csace22003/Airdahl/README.md

# Airdahl
Big Bad Capstone Flight Computer
