csace22003/Airdahl/GPT Response to Airdahl Schematic.docx

Yes. I parsed the uploaded KiCad schematic and traced the nets. I see several items worth fixing or at least verifying before layout/fabrication.

The most important one is the USB-to-UART connection around U2 (MCP2200) and U1 (STM32F446). In the schematic, U2 TX is on the net UART_TX, and that same net reaches U1 PA11. U2 RX is on UART_RX, but I do not see that net reaching an STM32 UART RX pin. In other words, the bridge appears to have TX connected to a pin that is not an obvious USART TX/RX counterpart, while RX is not connected to the MCU. The schematic itself labels the intended UART assignment as RX: PC10 / TX: PC11, so this looks inconsistent with the actual net connectivity.

I would therefore check the intended UART channel first. If you intend to use USART3 on PC10/PC11, then typically the bridge should be cross-connected:

MCP2200 TX→STM32 RX MCP2200 RX←STM32 TX

and the selected STM32 pins need to support that USART alternate function. At present, PC10 and PC11 also appear to be involved in the SDIO-related routing through the 22- Ω resistors, so there may also be a pin-multiplexing conflict depending on your firmware/interface plan.

A second issue is the SPI chip-select path. The carrier-board connector has a net named SPI_CS, but the MCU-side SPI chip-select appears to be named CS_RFM on a different net. I do not see those two nets joined. If SPI_CS is intended to be driven by the STM32, that connection looks missing. The clock, MISO, and MOSI paths are present, so the isolated CS net stands out.

A third thing I would verify is the MCP2200 exposed pad. U2 is using the QFN-20-1EP footprint, and the schematic symbol includes pin 21 EP. In the parsed schematic, that pin does not appear electrically connected to GND. For an exposed-pad QFN device, this is normally something you should explicitly verify against the Microchip datasheet and footprint implementation. I would not leave the thermal/exposed pad floating unless the datasheet specifically permits it.

There are also several lower-level items I would review:

- The USB-C CC1 and CC2 pins each have 5.1 kΩ to ground, which is correct for a USB device/UFP configuration.
- USB D+ and D− are correctly paired between the USB-C receptacle and MCP2200.
- The USB shield is tied directly to digital GND. That can work, but for EMC/ESD-sensitive hardware you may want to reconsider whether you want direct grounding, RC/chassis coupling, or a dedicated shield strategy.
- I do not see obvious USB ESD protection on D+/D− or VBUS. That is not logically required for operation, but for a flight-computer board it is worth adding.
- U7, the NCP1117-3.3, has 10-µF input and output capacitors, which is sensible for that regulator family.
- The STM32 has the expected VCAP capacitor and multiple VDD decoupling capacitors; the general architecture looks reasonable.
- VDDA is fed from 3.3 V through ferrite bead L1 and has local capacitors, which is good practice.
- The RTC backup battery is connected to VBAT and ground in a conventional manner.
- BOOT0 has a pulldown and switch network, and NRST has the expected reset-switch/capacitor network.

One thing that caught my attention structurally is that J2 and J3, the two 34-pin board-to-board connectors, do not appear to carry any GND pins in this schematic. They carry many digital/analog signals and +3V3_REG, but I do not see a ground connection through either connector. If those connectors mate this mainboard to carrier boards, this would be a serious concern unless ground is provided mechanically or through some other connector not shown. High-speed interfaces such as SPI/SDIO particularly need a defined return path. I would verify this before anything else on the connector design.

I would rank the findings this way:

1. High priority: UART connection around MCP2200 ↔ STM32 looks wrong/incomplete.
2. High priority: Verify that J2/J3 really have no GND conductors.
3. Medium-high priority: SPI_CS and CS_RFM appear to be separate nets.
4. Medium priority: MCP2200 exposed pad appears unconnected.
5. Design robustness: add/review USB ESD protection and shield grounding.
6. Pin-mux review: make sure UART, SDIO, SPI, and payload functions do not claim the same STM32 pins.

The rest of the power architecture, STM32 decoupling, USB-C CC configuration, oscillator networks, and basic reset/boot circuitry look broadly sensible from the connectivity I traced.

If you want, I can do a more systematic pin-by-pin design review next, organized as:

power → STM32 pins → USB/MCP2200 → clocks → SWD → J2/J3 carrier interface → SPI/I²C/SDIO → LEDs/buttons, and produce a table of every suspect net and recommended correction.

I went through the uploaded AirDahl Flight Computer Mainboard schematic at the net level and cross-checked the more important device requirements against the relevant datasheets. There are several real issues I would address before PCB fabrication.

One correction to my previous response first: the MCP2200 exposed pad is not an error. Microchip explicitly allows the EP to be either left electrically unconnected or tied to VSS. (Microchip (https://ww1.microchip.com/downloads/en/DeviceDoc/22228A.pdf?utm_source=chatgpt.com))

### Systematic review

Priority | Circuit / net | What I found | Recommendation
High | MCP2200 ↔ STM32 UART | MCP2200 TX (U2 pin 7) goes to UART_TX, which is connected to STM32 PA11. MCP2200 RX (pin 9) goes to UART_RX, but that net only reaches J3 and does not reach the MCU. Therefore the USB-UART bridge is not wired as a functional full-duplex MCU UART. | Reroute TX/RX to a valid STM32 UART pair and cross-connect: MCP2200 TX → MCU RX, MCP2200 RX ← MCU TX.
High | UART annotation / SDIO conflict | The schematic note says RX: PC10, TX: PC11. That is reversed: on STM32F446, PC10 = USART3_TX and PC11 = USART3_RX. Worse, PC10 and PC11 are already being used as SDIO_D2 and SDIO_D3. (STMicroelectronics (https://www.st.com/resource/en/datasheet/DM00141306.pdf?utm_source=chatgpt.com)) | Decide whether you need 4-bit SDIO and the USB UART simultaneously. If yes, choose a different UART pair, e.g. USART1 PA9/PA10 or USART3 PB10/PB11 if those pins are available.
High | J2/J3 ground return | I find no GND pins on either 34-pin board-to-board connector. Both carry signals and +3V3_REG, but no electrical ground net. | If these are the only connections to the carrier boards, add several GND pins. Ideally intersperse ground near SPI/UART and power pins. If a separate ground connection exists elsewhere, document it clearly.
High | Main +3.3-V rail after Schottky ORing | USB_3V3, SWD_3V3, and +3V3_REG are ORed through RB496EA Schottkys into +3V3. So the MCU and MCP2200 do not necessarily see 3.3 V; they see 3.3-V_F . RB496EA specifies V_F up to 0.4 V at 1 A. MCP2200 requires VDD ≥3.0 V. (Rohm (https://www.rohm.com/products/diodes/schottky-barrier-diodes/low-vf/rb496ea-product)) | Calculate the rail at worst-case current and temperature. A 3.3-V source followed by a diode is marginal for a nominal 3.3-V system. An ideal-diode/power-mux arrangement would be preferable.
High/conditional | +3V3_REG from J2 and J3 | J2 pin 7 and J3 pin 8 appear directly tied to the same pre-OR +3V3_REG net. | If both carrier boards can independently source 3.3 V, their regulators could be directly paralleled/back-fed. Give each source its own isolation/ORing unless only one can ever be installed/powered.
Medium-high | PB2 / BOOT1 | PB2 is labeled/noted as BOOT1, but appears otherwise floating. Your BOOT0 switch can force BOOT0 high. | If you want reliable entry into the STM32 system-memory bootloader, give PB2/BOOT1 a defined state—typically a pulldown. Otherwise BOOT0=1 can give an indeterminate boot selection.
Medium-high | DEBUG_LED | D5/R51 are connected to a net named DEBUG_LED, but I do not find that net connected to the STM32 or any other driver. | Connect it to an available MCU GPIO or remove it. As drawn, it cannot be software-controlled.
Medium-high | J3 SPI_CS | J3 carries SCLK, MISO, and MOSI, which correctly join the MCU SPI bus, but J3's SPI_CS is not connected to a GPIO. CS_RFM is a different chip-select used by the sensor sheet. | If J3's carrier contains an SPI slave, connect SPI_CS to a separate MCU GPIO. Do not simply merge it with CS_RFM unless the two devices are intentionally selected together.
Medium | MCP2200 VUSB bypass | U2 VUSB is tied to +3V3, which is appropriate at 3.3-V operation, but I do not see a dedicated local VUSB bypass capacitor. Microchip explicitly requires/recommends local high-quality ceramic bypassing; its characterization uses 330 nF. (Microchip (https://ww1.microchip.com/downloads/en/DeviceDoc/22228A.pdf)) | Put roughly 330 nF ceramic directly at VUSB-to-GND, with short traces.
Medium | USB VBUS capacitance | C1 is 10 µF directly on USB VBUS. Microchip notes that total effective capacitance across VBUS must not exceed 10 µF for bus-powered operation unless inrush limiting is provided. (Microchip (https://ww1.microchip.com/downloads/en/DeviceDoc/22228A.pdf?utm_source=chatgpt.com)) | 10 µF nominal leaves little design margin. Verify effective capacitance/tolerance and USB-C inrush behavior.
Medium | NCP1117 output capacitor | C2 is 10 µF, which satisfies the capacitance requirement, but the NCP1117 also specifies an ESR stability range, typically 33 mΩ–2.2 Ω. A modern low-ESR 10-µF ceramic can fall below that. (onsemi (https://www.onsemi.com/download/data-sheet/pdf/ncp1117-d.pdf?utm_source=chatgpt.com)) | Check the exact capacitor ESR over frequency/temp/DC bias, or select an LDO explicitly stable with ceramic output capacitors.
Medium | NCP1117 thermal dissipation | USB power goes 5 V → NCP1117 3.3 V → Schottky → board. At significant current the regulator must dissipate approximately (5-3.3)I , before considering diode loss. | Check worst-case board load and SOT-223 thermal design. At hundreds of mA this becomes nontrivial.
Medium | SWD connector | J1 has SWD_3V3, SWDIO, SWCLK, and GND, but no NRST. Also SWD_3V3 is arranged as a source into the board through D1. | Confirm your debugger actually supplies target power. Many SWD probes expect VTref to be supplied by the target. Adding NRST also improves recovery/connect-under-reset capability.
Medium | USB ESD | I don't see low-capacitance TVS/ESD protection on USB D+/D− or VBUS. | Add USB-rated ESD protection close to J4 if this connector will be routinely handled.
Medium/conditional | Primary Sensors sheet pins | At the top level, BMP_INT, BNO_INT, BNO_RST, D0_RFM, and RST_RFM appear unconnected. | Check whether they are intentionally unused and whether reset/input states are defined inside sensors.kicad_sch. I cannot verify the child circuitry because that file was not included.
Low/medium | ADC inputs PC0/PC1 | PITOT_SGL and PAYLOAD_A each have 100-nF shunt capacitance but no explicit series resistance. | Verify sensor output impedance and STM32 ADC acquisition requirements. If these are intended as low-pass filters, an explicit series R gives you a predictable pole and isolates the ADC/sensor from the capacitor.
Low | RB496EA lifecycle | ROHM lists RB496EA as Not Recommended for New Designs. (Rohm (https://www.rohm.com/products/diodes/schottky-barrier-diodes/low-vf/rb496ea-product)) | For a new board, consider a current-production replacement or an ideal-diode/power-mux solution.
Low / ERC hygiene | Power flags | I did not see PWR_FLAG-style power-source declarations. Because the board rail is fed through passive diode pins, KiCad ERC may not recognize +3V3 as actively driven. | Add appropriate power flags after validating the actual power architecture. This is primarily an ERC bookkeeping issue.

### Interfaces that otherwise look correct

The SPI1 mapping is coherent: PA5 → SCLK, PA6 → MISO, PA7 → MOSI, and PA4 → CS_RFM; the 22-Ω series resistors on several driven lines are reasonable. I²C1 on PB8/PB9 has 4.7-kΩ pullups. The SDIO 4-bit mapping is also internally consistent: PC8=D0, PC9=D1, PC10=D2, PC11=D3, PC12=CLK, and PD2=CMD, which reinforces why PC10/PC11 cannot simultaneously serve as your intended USART3 pair. (STMicroelectronics (https://www.st.com/resource/en/datasheet/DM00141306.pdf?utm_source=chatgpt.com))

The STM32 power implementation is generally good: all VDD/VSS pins appear connected, VDDA is filtered through L1 with local 100-nF/1-µF decoupling, and VCAP1 uses 4.7 µF. ST specifically calls for 4.7 µF with ESR ≤1 Ω for the single-VCAP configuration of this device. (STMicroelectronics (https://www.st.com/resource/en/datasheet/stm32f446rc.pdf?utm_source=chatgpt.com)) The VBAT arrangement, HSE/LSE topology, NRST network, and BOOT0 pulldown/switch also look sensible.

The USB-C device configuration also has the expected 5.1-kΩ Rd resistors on CC1 and CC2. D+/D− are connected correctly to the MCP2200, and the MCP2200 already contains the USB impedance-matching/termination components, so you do not need external series termination resistors solely for that purpose. (Microchip (https://ww1.microchip.com/downloads/en/DeviceDoc/22228A.pdf))

### What I would change before ordering the PCB

The four items I would treat as must-resolve are:

1. Fix the MCP2200 UART routing and the erroneous PC10/PC11 annotation.
2. Confirm/add ground connections on J2 and J3.
3. Reconsider the 3.3-V-through-Schottky power architecture, especially because MCP2200 has a 3.0-V minimum.
4. Determine whether J2 and J3 can both source +3V3_REG; if so, isolate the two sources.

After that, I would fix DEBUG_LED, SPI_CS, PB2/BOOT1, and add the MCP2200 VUSB bypass capacitor.

One important limitation remains: the main schematic references sensors.kicad_sch, but that child sheet was not included in the upload. So I have verified the mainboard-to-sensor-sheet interfaces but not the actual BNO/BMP/RFM/SD-card circuitry, its power decoupling, pullups, interrupt/reset handling, or SD-card implementation. If you upload sensors.kicad_sch, I can continue the same review through that sheet and give you a final “safe to fabricate / remaining blockers” checklist.
