csace22003/Airdahl/ACE Carrier/local-libraries/ADXL345/ADXL345.step

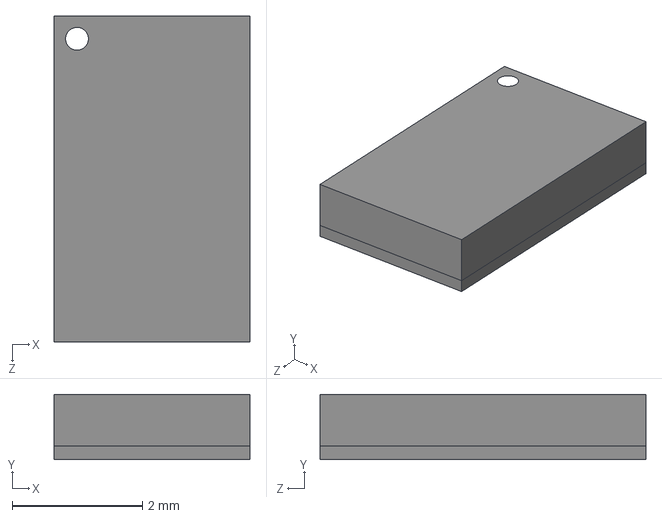
[picture p15: CAD file, 2026-04-10]
ACE Carrier/local-libraries/ADXL345/ADXL345.step
3.00 x 1.00 x 5.00 mm
