csace22003/Airdahl/Airdahl 1.0/local-libraries/ABM3B_8_000MHZ_12_D1X_T/ABM3B-8.000MHZ-12-D1X-T.step

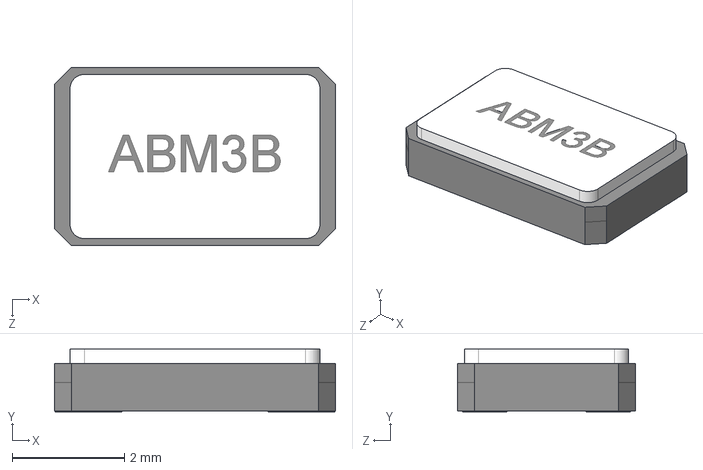
[picture p16: CAD file, 2026-03-30]
Airdahl 1.0/local-libraries/ABM3B_8_000MHZ_12_D1X_T/ABM3B-8.000MHZ-12-D1X-T.step
5.00 x 1.11 x 3.18 mm
