csace22003/Airdahl/Airdahl 1.0/local-libraries/ABS25_32_768KHZ_6_T/ABS25-32.768KHZ-6-T.step

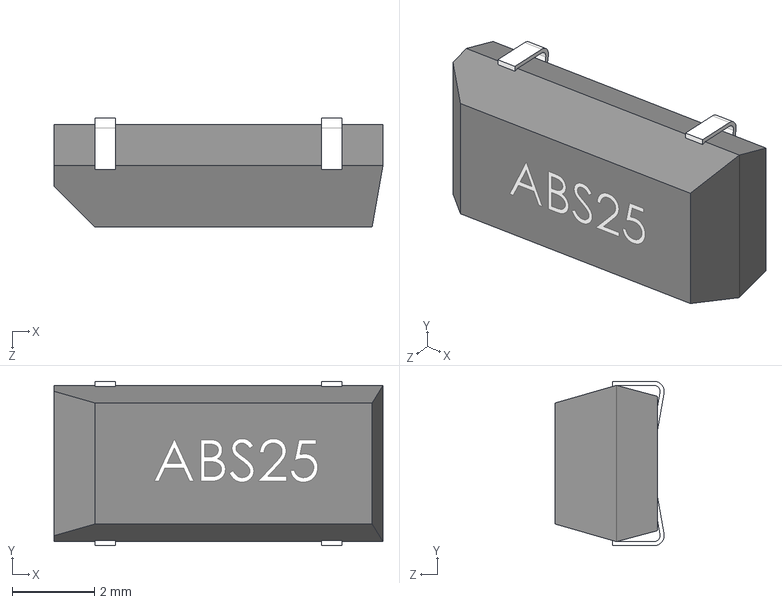
[picture p17: CAD file, 2026-03-27]
Airdahl 1.0/local-libraries/ABS25_32_768KHZ_6_T/ABS25-32.768KHZ-6-T.step
8.00 x 4.00 x 2.66 mm
