csace22003/Airdahl/Airdahl 1.0/local-libraries/BMP581/BMP581.step

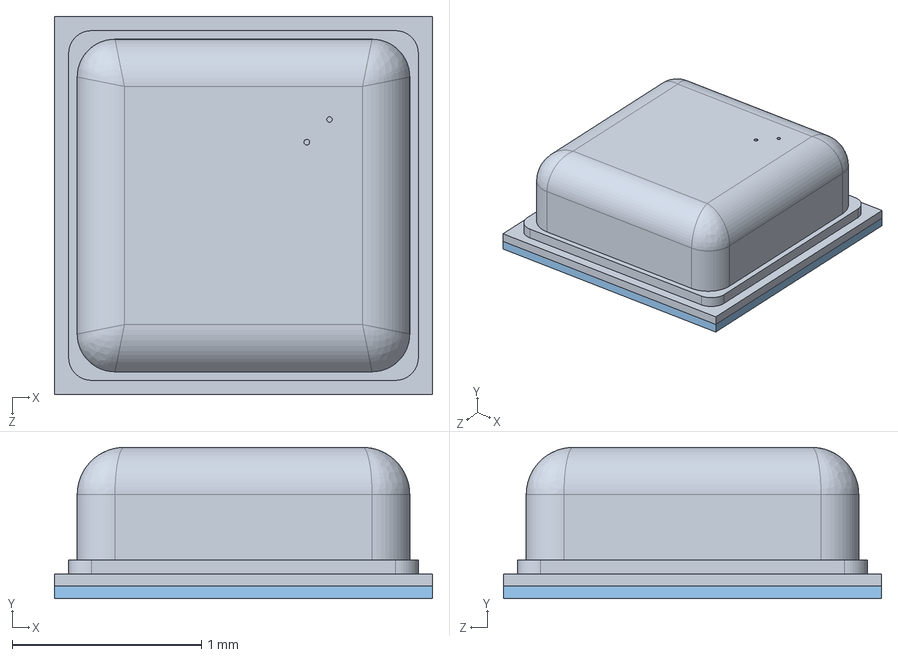
[picture p18: CAD file, 2026-04-10]
Airdahl 1.0/local-libraries/BMP581/BMP581.step
2.00 x 0.801 x 2.00 mm
