csace22003/Airdahl/Airdahl 1.0/local-libraries/BNO085/BNO085.step

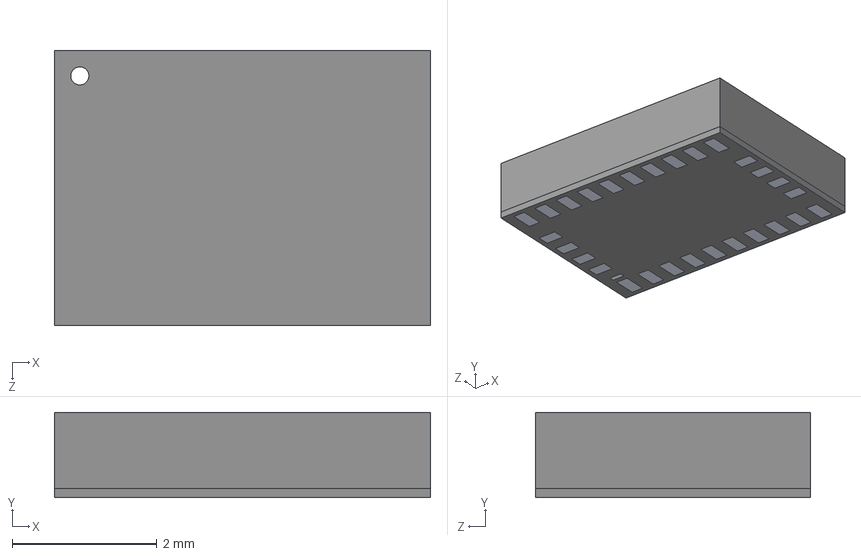
[picture p19: CAD file, 2026-04-10]
Airdahl 1.0/local-libraries/BNO085/BNO085.step
5.20 x 1.18 x 3.80 mm
