csace22003/Airdahl/Airdahl 1.0/local-libraries/CONUFL001-SMD-T/CONUFL001-SMD-T.step

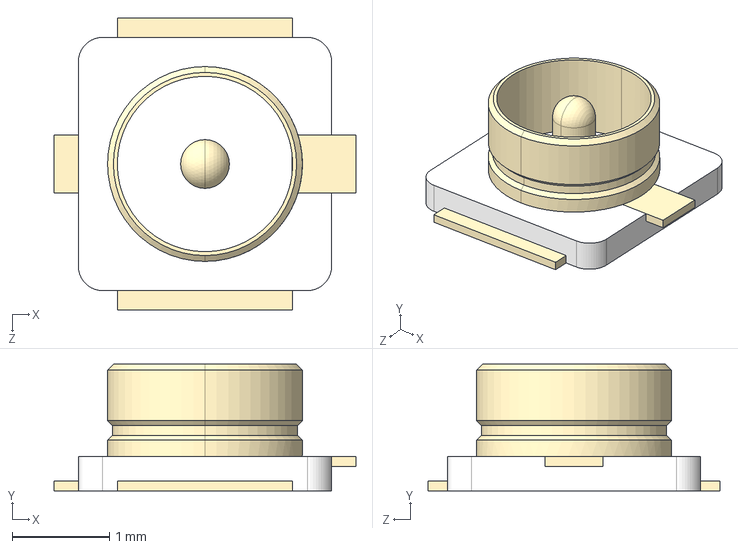
[picture p20: CAD file, 2026-04-17]
Airdahl 1.0/local-libraries/CONUFL001-SMD-T/CONUFL001-SMD-T.step
3.10 x 1.30 x 3.00 mm
