csace22003/Airdahl/Airdahl 1.0/local-libraries/DF40C-34DS-0.4V_58_/DF40C-34DS-0.4V_58_.step

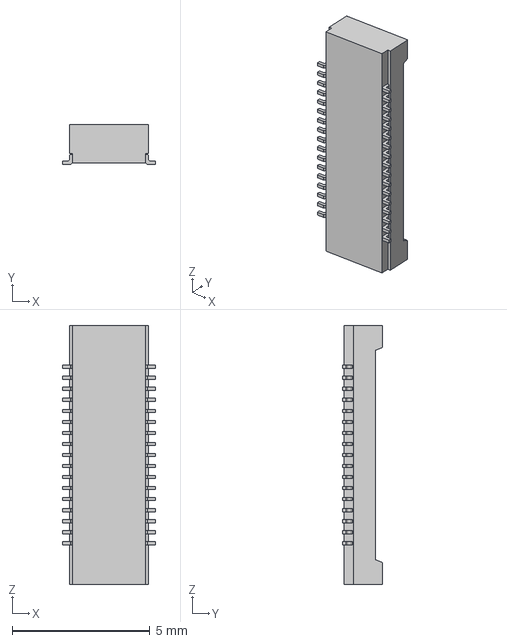
[picture p21: CAD file, 2026-08-17]
Airdahl 1.0/local-libraries/DF40C-34DS-0.4V_58_/DF40C-34DS-0.4V_58_.step
3.38 x 1.45 x 9.40 mm
