csace22003/Airdahl/Airdahl 1.0/local-libraries/LM66200DRLR/DRL0008A.stp

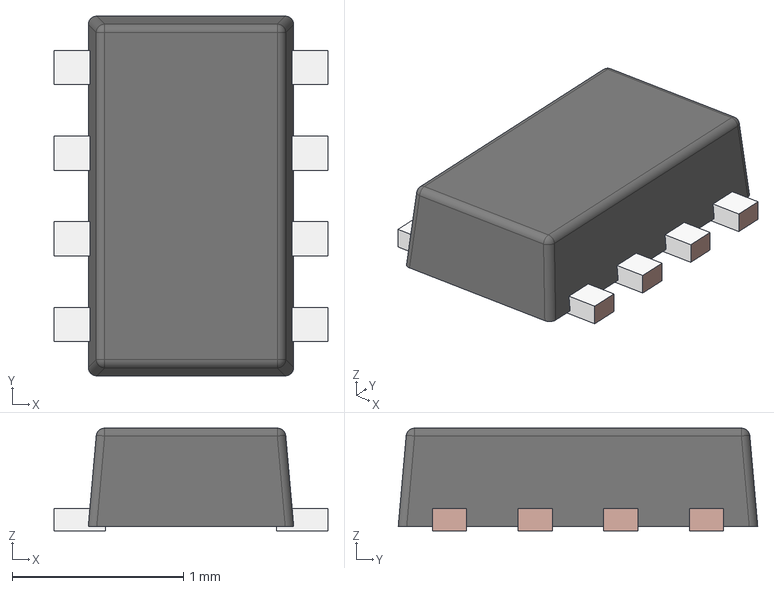
[picture p22: CAD file, 2026-09-29]
Airdahl 1.0/local-libraries/LM66200DRLR/DRL0008A.stp
1.60 x 2.10 x 0.6 mm
FRAME-DRL0008A
BODY-SOT
