csace22003/Airdahl/Airdahl 1.0/local-libraries/RFM95W-915S2/RFM95W-915S2.step

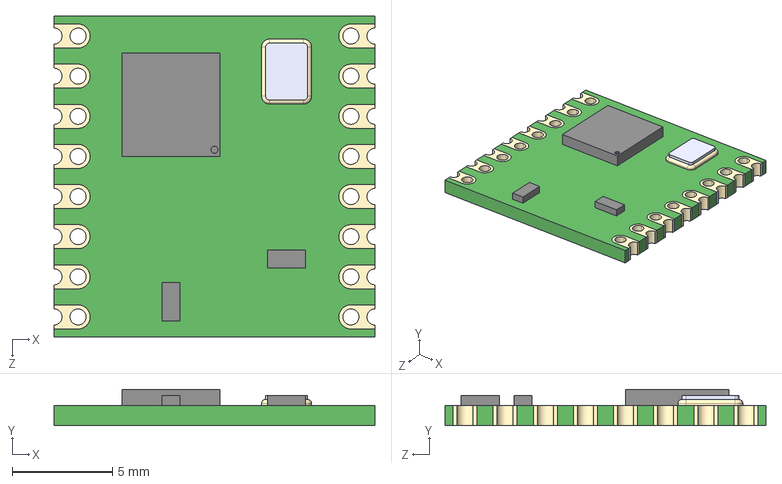
[picture p23: CAD file, 2026-04-17]
Airdahl 1.0/local-libraries/RFM95W-915S2/RFM95W-915S2.step
16.0 x 1.80 x 16.0 mm
