csace22003/Airdahl/Airdahl 1.0/local-libraries/SDM40E20LC_7/SOT-23_DIO.step

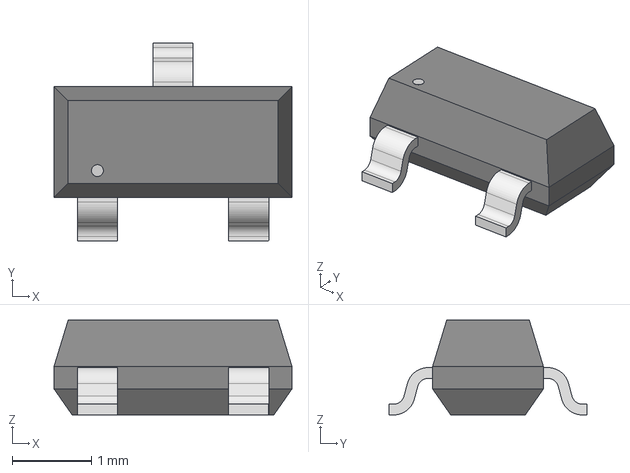
[picture p24: CAD file, 2026-03-29]
Airdahl 1.0/local-libraries/SDM40E20LC_7/SOT-23_DIO.step
3.00 x 2.49 x 1.20 mm
