csace22003/Airdahl/Airdahl 1.0/local-libraries/TLV62150RGTR/RGT0016C.stp

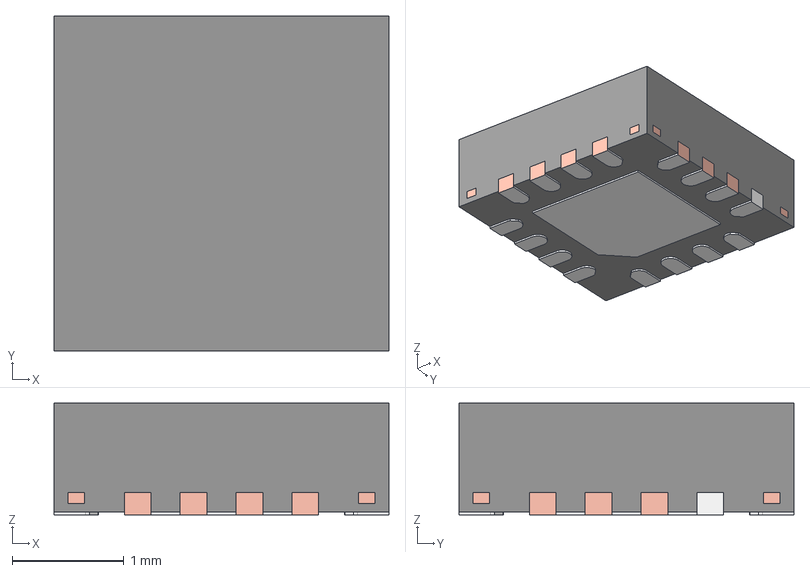
[picture p25: CAD file, 2026-03-29]
Airdahl 1.0/local-libraries/TLV62150RGTR/RGT0016C.stp
3.00 x 3.00 x 1.00 mm
BODY-QFN
FRAME-RGT0016C
PIN1-ID
