csace22003/Airdahl/RCE Carrier/local-libraries/DF40C-34DP-0.4V_58_/DF40C-34DP-0.4V_58_.step

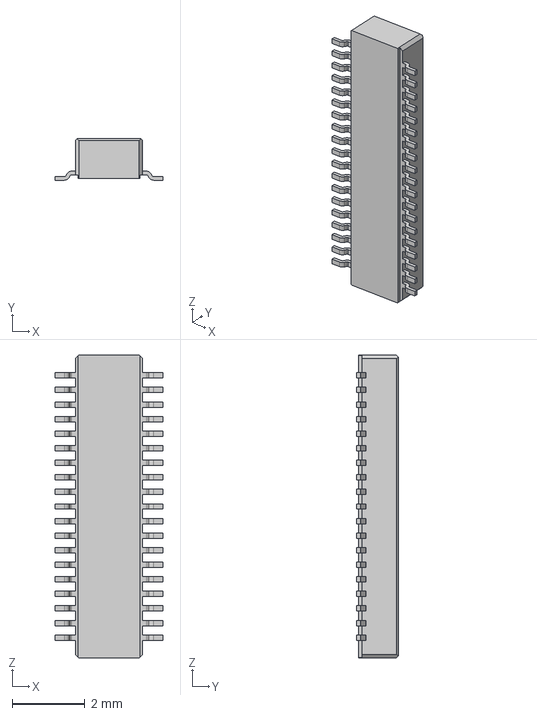
[picture p26: CAD file, 2026-08-17]
RCE Carrier/local-libraries/DF40C-34DP-0.4V_58_/DF40C-34DP-0.4V_58_.step
2.97 x 1.14 x 8.32 mm
