csace22003/Airdahl/RCE Carrier/local-libraries/Si7232DN/SI7232DN-T1-GE3.step

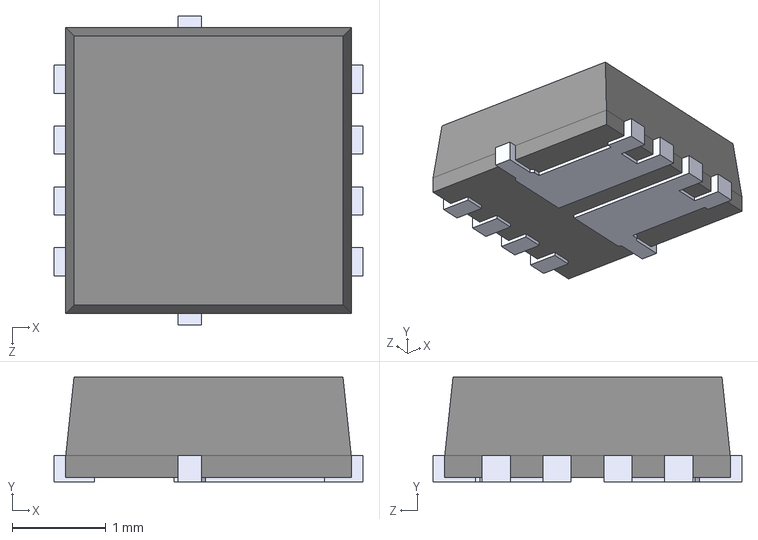
[picture p27: CAD file, 2026-09-28]
RCE Carrier/local-libraries/Si7232DN/SI7232DN-T1-GE3.step
3.30 x 1.12 x 3.30 mm
