csace22003/Airdahl/RCE Carrier/local-libraries/TBL002A-350-08GY-2GY/TBL002A-350-08GY-2GY.step

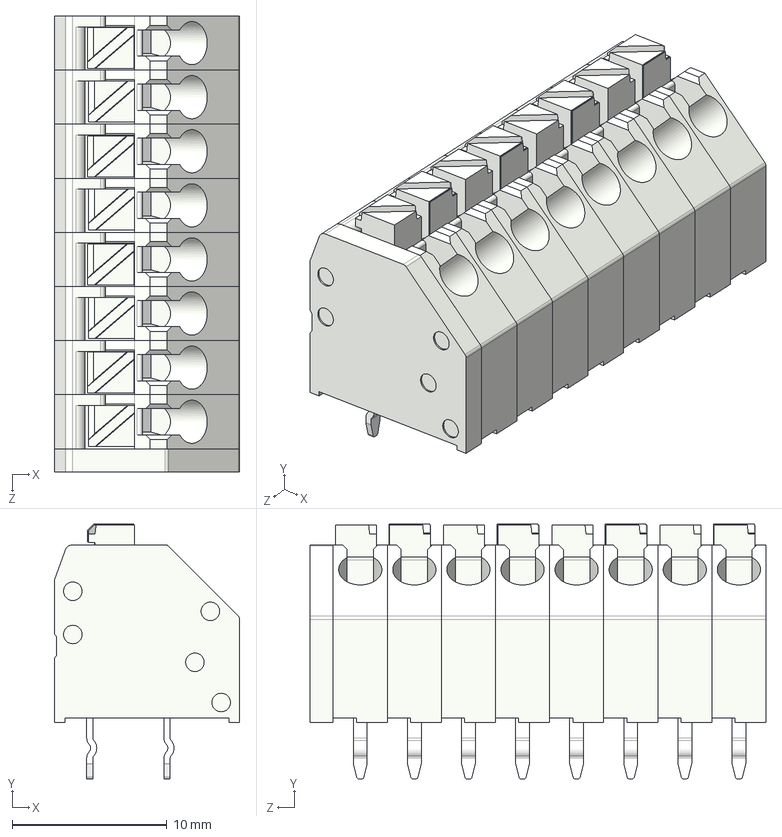
[picture p28: CAD file, 2026-03-29]
RCE Carrier/local-libraries/TBL002A-350-08GY-2GY/TBL002A-350-08GY-2GY.step
12.0 x 16.5 x 29.5 mm
TBL002A-350 - END CAP_Gray
TBL002A-350 - BODY A_Gray x 4
TBL002A-350 - BODY B_Gray x 4
TBL002A-350 - PUSH BUTTON A_Gray x 4
TBL002A-350 - PUSH BUTTON B_Gray x 4
