csace22003/Airdahl/RCE Carrier/local-libraries/XT30PW-M/XT30PW-M.step

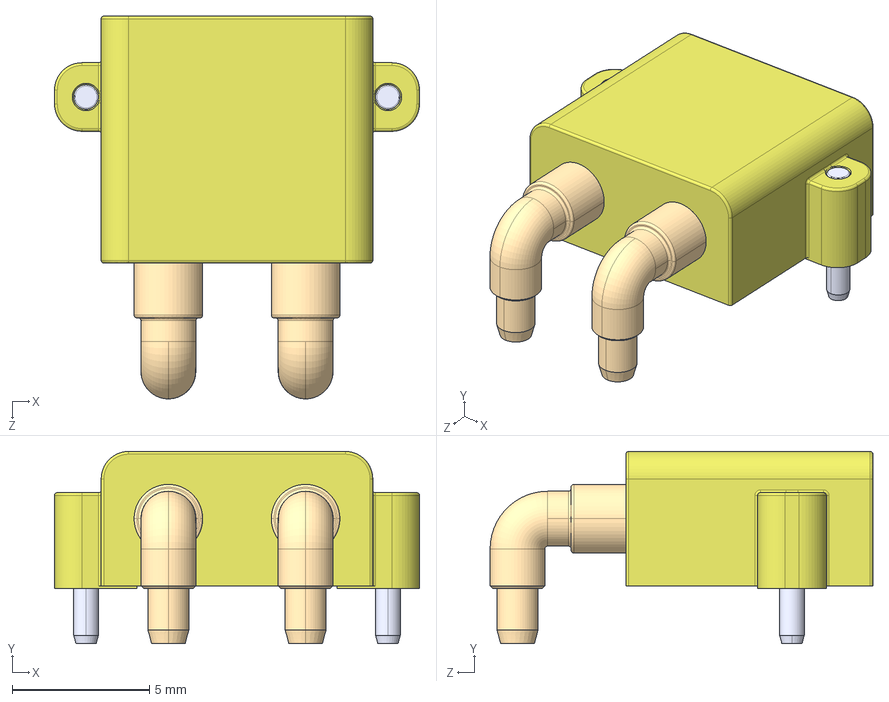
[picture p29: CAD file, 2026-09-08]
RCE Carrier/local-libraries/XT30PW-M/XT30PW-M.step
13.3 x 7.00 x 14.0 mm
