csace22003/Airdahl/RCE Carrier/local-libraries/XT30UPB-M/XT30UPB-M.step

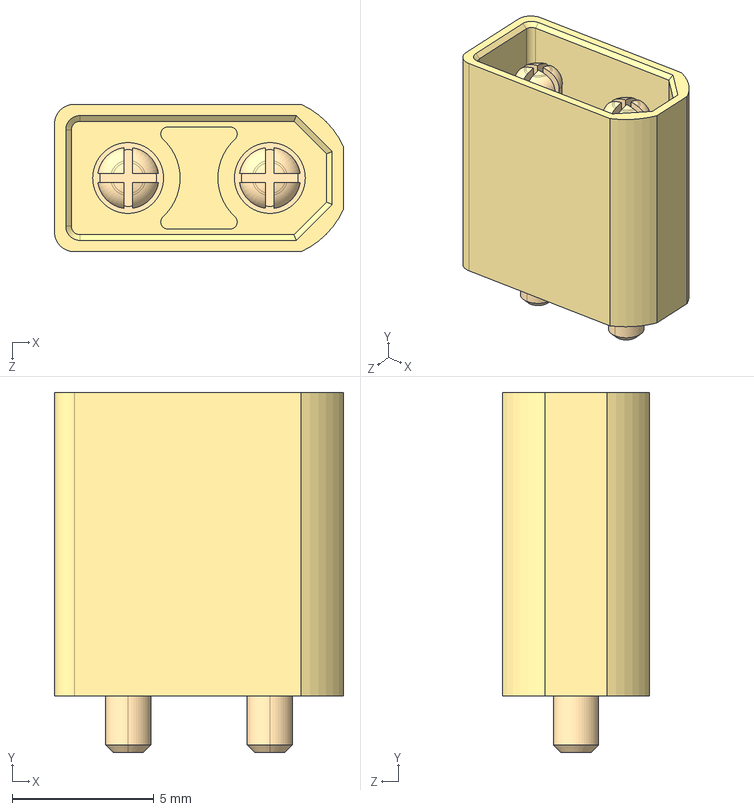
[picture p30: CAD file, 2026-09-25]
RCE Carrier/local-libraries/XT30UPB-M/XT30UPB-M.step
10.2 x 12.7 x 5.20 mm
