csace22003/Airdahl/RCE Carrier/local-libraries/XT60PW-F/XT60PW-F.step

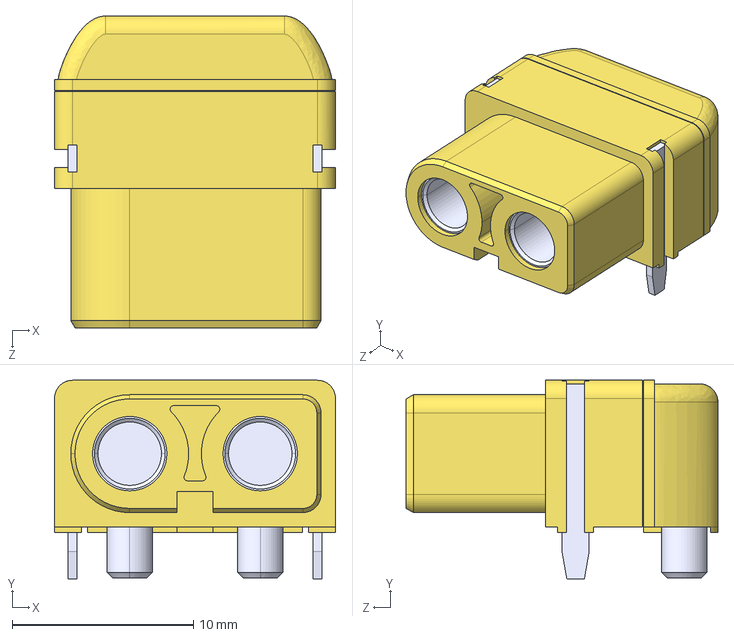
[picture p31: CAD file, 2026-03-29]
RCE Carrier/local-libraries/XT60PW-F/XT60PW-F.step
15.5 x 10.9 x 17.2 mm
