csace22003/Airdahl/Airdahl 1.0/local-libraries/104031-0811/104031-0811.step

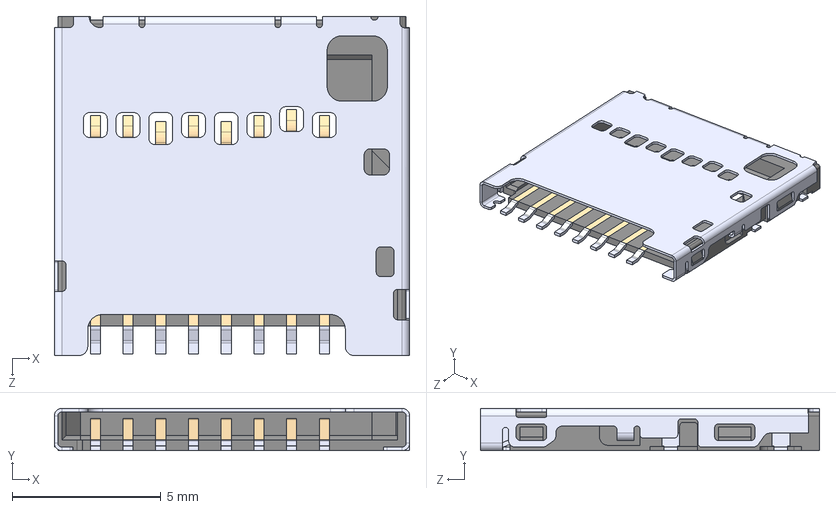
[picture p32: CAD file, 2026-06-07]
Airdahl 1.0/local-libraries/104031-0811/104031-0811.step
12.0 x 1.42 x 11.4 mm
