csace22003/Airdahl/(list of files, cad)

Other CAD files:
RCE Carrier/local-libraries/TPS54302DDCR/TPS54302DDCR.step
