csace22003/Airdahl/ace25-26-firmware/flight_platformio/src/capabilities/FlightMonitor.cpp

/* Source file for airbrakes flight monitor*/

// include class header
#include "FlightMonitor.h"
#include <IMPORTANT_CONFIG.h>

extern BLA::Matrix<9> stateVec;
extern BLA::Matrix<3> pointVec;
float tiltAngle;

FlightMonitor::FlightMonitor()
{
    launchCounts = 0;
    burnoutCounts = 0;
    apogeeCounts = 0;
    landingCounts = 0;
    tiltCounts=0;
}

bool FlightMonitor::detectedLaunch()
{
    if ((stateVec(2) > LAUNCH_HEIGHT_THRESHOLD) && (stateVec(5) > LAUNCH_VELOCITY_THRESHOLD)) {
        launchCounts += 1;
        //Serial.print("launch counted: ");
     } else {
        //Serial.print("reset launchCounts...");
        launchCounts = 0;
    }

    // Serial.println(launchCounts);

    if (launchCounts >= LAUNCH_PERSISTENCE){
        return true;
    } else {
        return false;
    }
}

bool FlightMonitor::detectedUnpoweredAscent()
{

    if(stateVec(8)<0){
        burnoutCounts++;
    }else{
        burnoutCounts = 0;
    }
    //if(stateVec(2)>0.5){
    //    burnoutCounts++;
    //}else{
    //    burnoutCounts = 0;
    //}

    if(burnoutCounts>=BURNOUT_PERSISTENCE){
        return true;
    }else{
        return false;
    }

}

bool FlightMonitor::detectedApogee()
{

    if((stateVec(2)>ACE_SHUTOFF_THRESHOLD)||(stateVec(5)<APOGEE_VELOCITY_THRESHOLD)){
        apogeeCounts++;
    }else{
        apogeeCounts = 0;
    }
    //if(stateVec(2)>0.75){
    //    apogeeCounts++;
    //}else{
    //    apogeeCounts = 0;
    //}

    if(apogeeCounts>=APOGEE_PERSISTENCE){
        return true;
    }else{
        return false;
    }

}

bool FlightMonitor::detectedLanding()
{
    if((stateVec(2)<LANDING_ALTITUDE_THRESHOLD)){
        landingCounts++;
    }else{
        landingCounts = 0;
    }

    if(landingCounts>=LANDING_PERSISTENCE){
        return true;
    }else{
        return false;
    }

}

bool FlightMonitor::detectedLean()
{
    float dotProduct = stateVec(3)*pointVec(0) + stateVec(4)*pointVec(1) + stateVec(5)*pointVec(2);
    float magnitude = sqrt(pow(stateVec(3),2)+pow(stateVec(4),2)+pow(stateVec(5),2));
    tiltAngle = acos(dotProduct/magnitude);

    if(tiltAngle>TILT_THRESHOLD){
        tiltCounts++;
    }else{
        tiltCounts=0;
    }
    
    if(tiltCounts>=TILT_PERSISTENCE && DISABLE_FAULT_PROTECTION==0){
        return true;
    }
    else{
        return false;
    }
}
