csace22003/Airdahl/ace25-26-firmware/flight_platformio/include/capabilities/SDlogger.h

#pragma once
#include <SD.h>
#include <SPI.h>

class SDLogger{
    private:
        String filename;
        bool fileOpen;
        File dataFile;
    public:
        SDLogger();
        bool initSD();
        bool writeCsvData(int numFields, float* dataArray, long dataSize);
        bool openFile();
        bool closeFile();
};
