csace22003/Airdahl/(commit log)

2026-03-27 its a kicad project
    [Airdahl 1.0.kicad_pcb, Airdahl 1.0.kicad_sch]
2026-03-27 wired 1 pin
    [Airdahl 1.0.kicad_sch]
2026-03-27 more wiring bing bong
    [ABS25-32.768KHZ-6-T.step, Airdahl 1.0.kicad_sch]
2026-03-27 capacitance values oop
    [Airdahl 1.0.kicad_sch]
2026-03-29 buck converter diode array and also pyro channels bc why not
    [Airdahl 1.0.kicad_sch, RGT0016C.stp, SOT-23_DIO.step, TBL002A-350-08GY-2GY.step, XT60PW-F.step, power_distribution.kicad_sch, pyro_channels.kicad_sch]
2026-03-30 HSE crystal + gaslit st-link into powering board
    [ABM3B-8.000MHZ-12-D1X-T.step, Airdahl 1.0.kicad_sch]
2026-04-07 switched out buck converter, added OR-ing between stlink and buck
    [Airdahl 1.0.kicad_sch, TPS54302DDCR.step, power_distribution.kicad_sch]
2026-04-10 basic i2c setup
    [ADXL345.step, Airdahl 1.0.kicad_sch, BMP581.step, BNO085.step, sensors.kicad_sch]
2026-04-11 wired up dat ho (sitting on int/rst signals until we figure out rest of gpio)
    [Airdahl 1.0.kicad_sch, sensors.kicad_sch]
2026-04-17 rfm wiring
    [Airdahl 1.0.kicad_sch, CONUFL001-SMD-T.step, RFM95W-915S2.step, sensors.kicad_sch]
2026-04-20 note on daughter board pinout if we go that route (also just pin reqs in general for power/motor)
    [power_distribution.kicad_sch, sensors.kicad_sch]
2026-06-07 added 3.3V LDO, SD Card, spi breakout
    [104031-0811.step, Airdahl 1.0.kicad_sch, power_distribution.kicad_sch, sensors.kicad_sch]
2026-06-13 added 5v buck, h bridge IC, updated jtag connections
    [Airdahl 1.0.kicad_sch, power_distribution.kicad_sch, pyro_channels.kicad_sch, sensors.kicad_sch]
2026-06-21 reworked pyro circuit for higher current, split off pyro 3.3v into its own rail, some schematic cleanup
    [Airdahl 1.0.kicad_sch, power_distribution.kicad_sch, pyro_channels.kicad_sch]
2026-08-16 added missing decoupling caps and fixed mcu resistor footprints
    [Airdahl 1.0.kicad_sch]
2026-08-17 restructured airdahl for carrier boards, switched 20 pin debug jtag for 10 pin for use with adafruit usb stlink, schematic formatting
    [ACE Carrier.kicad_pcb, ACE Carrier.kicad_sch, ADXL345.step, Airdahl 1.0.kicad_sch, DF40C-34DP-0.4V_58_.step, DF40C-34DS-0.4V_58_.step, PCE-RCE Carrier.kicad_pcb, PCE-RCE Carrier.kicad_sch]
2026-08-23 swd and uart interfaces for mainboard, updated power or-ing circuit
    [Airdahl 1.0.kicad_sch]
2026-08-23 fixed usbc cc pins, boot0 button, uart connections
    [Airdahl 1.0.kicad_sch]
2026-08-23 apparently you can use mlcc with the ldo oop
    [Airdahl 1.0.kicad_sch]
2026-08-25 added led and others
    [Airdahl 1.0.kicad_sch, sensors.kicad_sch]
2026-08-25 vbus is no longer shorted to 3v3
    [Airdahl 1.0.kicad_sch]
2026-08-25 added to carrier board port pinout, need to add to mcu
    [Airdahl 1.0.kicad_sch, sensors.kicad_sch]
2026-08-27 MAIN BOARD SCHEMATIC REV1
    [Airdahl 1.0.kicad_sch]
2026-08-27 stoning my cap
    [Airdahl 1.0.kicad_sch, power_distribution.kicad_sch, sensors.kicad_sch]
2026-08-27 stoning my cap pt.2
    [sensors.kicad_sch]
2026-08-31 added 5v power to ace carrier for pitot tube, dsub-9 pinouts, voltage divider for pitot sensor signal, changed vbus ldo on mainboard to ncp1117
    [ACE Carrier.kicad_sch, Airdahl 1.0.kicad_sch, airbrakes_sensors.kicad_sch, power.kicad_sch]
2026-09-02 switched dsub with jst
    [airbrakes_sensors.kicad_sch]
2026-09-03 added pinouts for board interface, b3b xh servo connector and 6v buck to ace carrier
    [ACE Carrier.kicad_sch, Airdahl 1.0.kicad_sch, airbrakes_sensors.kicad_sch, breakout.kicad_sch, power.kicad_sch]
2026-09-03 added remaining unused gpio to carrier board interface on mainboard schematic
    [Airdahl 1.0.kicad_sch]
2026-09-03 adc filtering caps
    [Airdahl 1.0.kicad_sch]
2026-09-06 updated v div values
    [airbrakes_sensors.kicad_sch]
2026-09-08 H-Bridge wiring + motor ports, cleaned up carrier schematics, added MISO source terminating resistors on carriers
    [ACE Carrier.kicad_sch, Airdahl 1.0.kicad_sch, PCE-RCE Carrier.kicad_sch, XT30PW-M.step, breakout.kicad_sch, power.kicad_sch, power_distribution.kicad_sch, pyro.kicad_sch]
2026-09-15 some updates, mostly comments after schematic review
    [Airdahl 1.0.kicad_sch, power.kicad_sch, sensors.kicad_sch]
2026-09-15 added ace firmware from last year as a reference - code does not work currently :(
2026-09-16 updated ACE carrier local libraries, put footprints in layout file
    [ACE Carrier.kicad_pcb, TPS54302DDCR.step, XT60PW-F.step, breakout.kicad_sch, power.kicad_sch]
2026-09-16 started main board layout
    [Airdahl 1.0.kicad_pcb, Airdahl 1.0.kicad_sch]
2026-09-16 routed decoupling caps, might have to change in value.
    [Airdahl 1.0.kicad_pcb]
2026-09-16 changed some of the connector pinouts, started some other routing
    [Airdahl 1.0.kicad_pcb, Airdahl 1.0.kicad_sch]
2026-09-17 the diff pairs are eating my lunch
    [Airdahl 1.0.kicad_pcb, Airdahl 1.0.kicad_sch]
2026-09-17 dorothy comments (primary sensors except BNO)
    [Airdahl 1.0.kicad_sch, sensors.kicad_sch]
2026-09-17 rest of comments for mainboard
    [Airdahl 1.0.kicad_sch]
2026-09-19 routing changes
    [Airdahl 1.0.kicad_pcb, Airdahl 1.0.kicad_sch, power_distribution.kicad_sch, pyro_channels.kicad_sch, sensors.kicad_sch]
2026-09-24 idk what i have but there are certainly changes
    [Airdahl 1.0.kicad_pcb, Airdahl 1.0.kicad_sch, power_distribution.kicad_sch, pyro_channels.kicad_sch, sensors.kicad_sch]
2026-09-25 carrier board comments
    [PCE-RCE Carrier.kicad_sch, airbrakes_sensors.kicad_sch, power.kicad_sch, power_distribution.kicad_sch, pyro.kicad_sch]
2026-09-25 footprint libraries and initial board setup
    [PCE-RCE Carrier.kicad_pcb, PCE-RCE Carrier.kicad_sch]
2026-09-25 mfw high power components are large
    [PCE-RCE Carrier.kicad_pcb, XT30UPB-M.step, breakout.kicad_sch, power_distribution.kicad_sch]
2026-09-26 initial component placement can you feel the layout hell
    [PCE-RCE Carrier.kicad_pcb]
2026-09-27 potentially better placement that was revealed to me in my shower
    [PCE-RCE Carrier.kicad_pcb]
2026-09-27 some pce routing, switched out ace battery connectors for vertical xt30
    [PCE-RCE Carrier.kicad_pcb, XT30UPB-M.step, power.kicad_sch, power_distribution.kicad_sch]
2026-09-28 updated pyro circuit to be like easymini, lowk will prob make it a separate carrier
    [PCE-RCE Carrier.kicad_pcb, PCE-RCE Carrier.kicad_sch, SI7232DN-T1-GE3.step, breakout.kicad_sch, power_distribution.kicad_sch, pyro.kicad_sch]
2026-09-29 power or-ing changes
    [Airdahl 1.0.kicad_pcb, Airdahl 1.0.kicad_sch, DRL0008A.stp, power_distribution.kicad_sch, pyro_channels.kicad_sch, sensors.kicad_sch]
2026-10-02 split pce and rce functions into two carriers, initial rce parts placement
    [DF40C-34DP-0.4V_58_.step, RCE Carrier.kicad_pcb, RCE Carrier.kicad_sch, SI7232DN-T1-GE3.step, TBL002A-350-08GY-2GY.step, TPS54302DDCR.step, XT30PW-M.step, XT30UPB-M.step]
2026-10-02 test commit
    [Airdahl 1.0.kicad_sch]
2026-10-04 PCE wiring except solenoids and 3V3 in
    [PCE-RCE Carrier.kicad_pcb, power_distribution.kicad_sch]
2026-10-04 RCE wiring except 3V3 in
    [RCE Carrier.kicad_pcb]
2026-10-06 added payload solenoid gpio, 3v3 rail from power mux to carriers, finished wiring
    [Airdahl 1.0.kicad_sch, PCE-RCE Carrier.kicad_pcb, PCE-RCE Carrier.kicad_sch, RCE Carrier.kicad_pcb, RCE Carrier.kicad_sch, breakout.kicad_sch, power_distribution.kicad_sch]
2026-10-06 missed an unconnected net
    [RCE Carrier.kicad_pcb]
2026-10-08 added telemega data fr this time
    [TeleMega4-19-26.csv]
2026-10-11 some silkscreen + rounded corners on PCE
2026-10-11 more silkscreen and layout touch up
2026-10-11 RCE silkscreen + rounding corners
2026-10-15 silkscreen shenanigans
